stpotomotif/PROYEK_BMS_NUVOTON/PROYEK_BMS_NUVOTON.kicad_pcb

## KiCad design PROYEK_BMS_NUVOTON.kicad_pcb (2024-03-11)

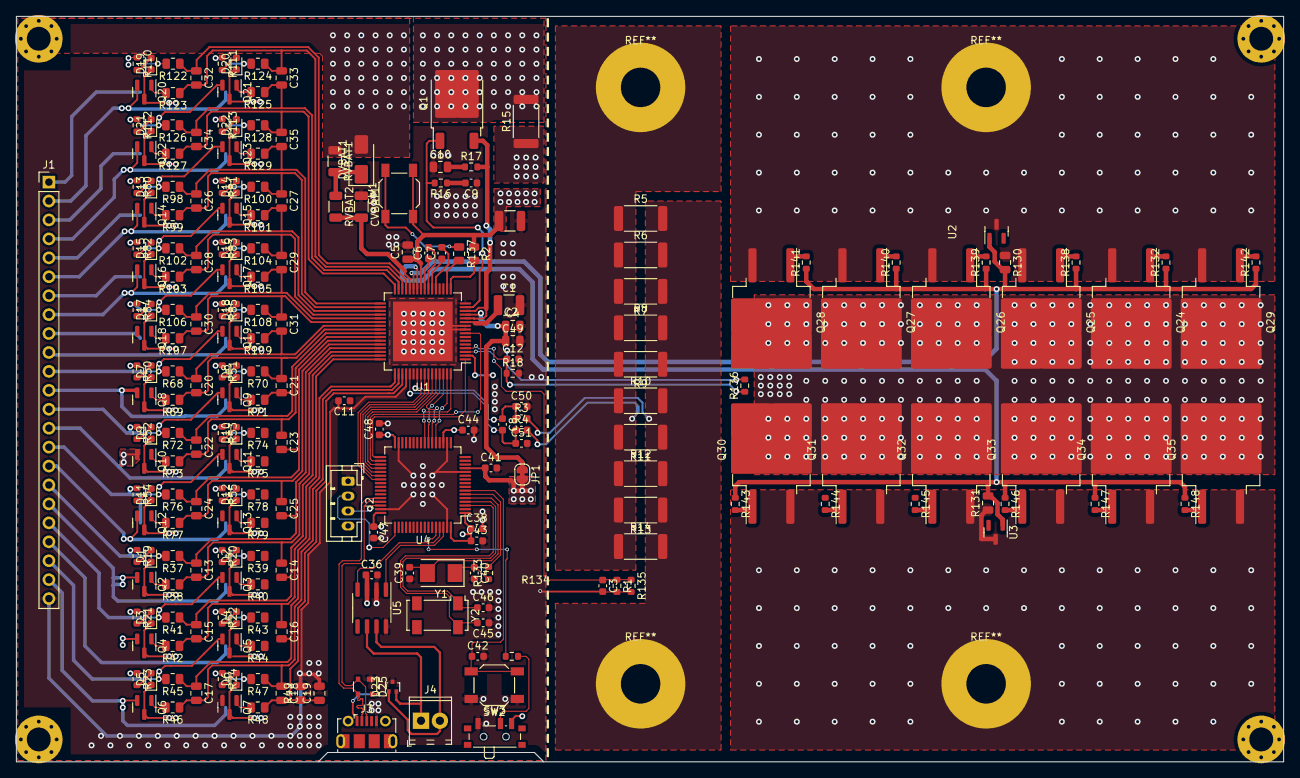
[picture p1: board PROYEK_BMS_NUVOTON.kicad_pcb from above]

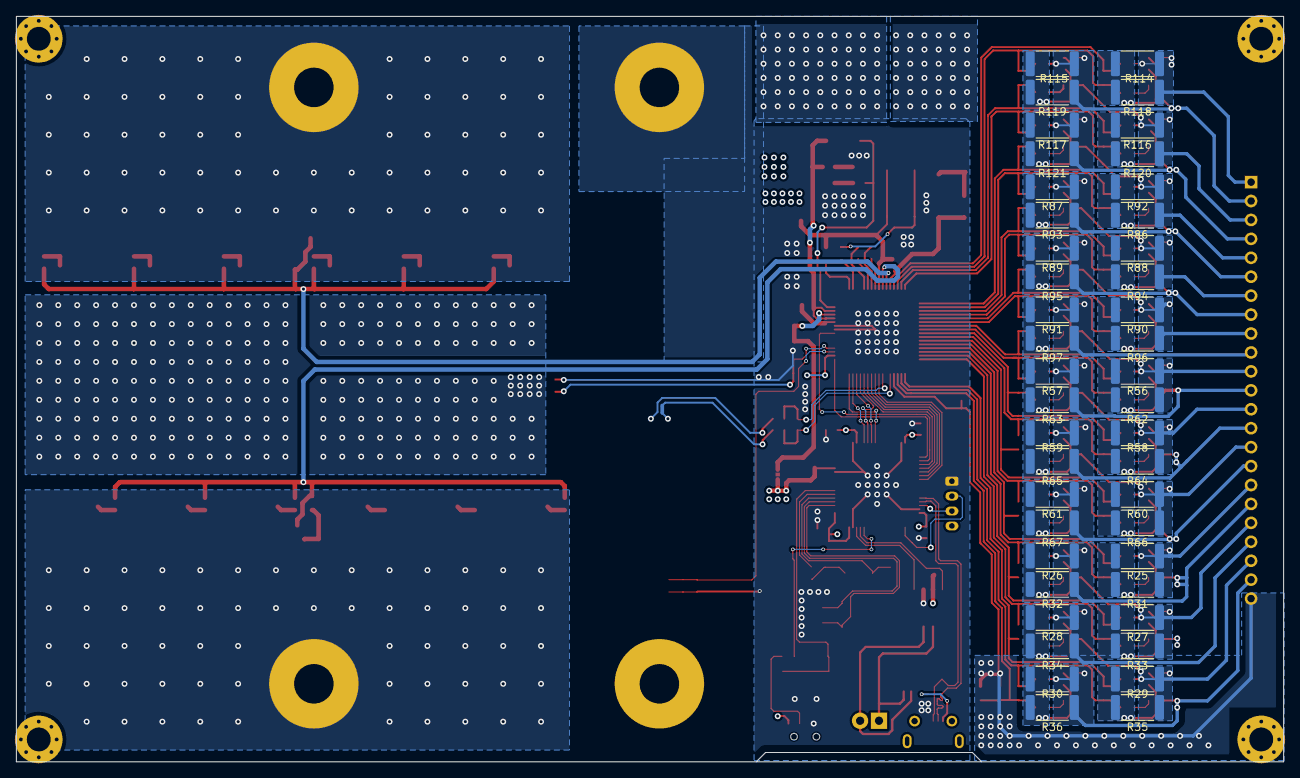
[picture p2: board PROYEK_BMS_NUVOTON.kicad_pcb from below]

Board: 4 copper layers, 170.0 x 100.0 mm, 277 parts (45 on the bottom side), 179 nets.

Parts:
C1: 4.7u; C_1210_3225Metric
C2: 1u; C_1210_3225Metric
C3, C12: 1n; C_0603_1608Metric
C4: 1u; C_0805_2012Metric
C5: 0.1u; C_0805_2012Metric
C6, C7: 0.68u; C_0603_1608Metric
C8, C50, C51: 0.1u; C_0603_1608Metric
C9: 22n; C_0603_1608Metric
C10: 10u; C_0805_2012Metric
C11: 100n; C_0603_1608Metric
C13, C14, C15, C16, C17, C18, C19, C20, C21, C22, C23, C24, C25, C26, C27, C28, C29, C30, C31, C32, C33, C34, C35: 180n; C_0805_2012Metric
C36, C38, C41, C42, C43, C44, C47: 100n,0603; C_0603_1608Metric
C39, C40, C45, C46: 20p,0603; C_0603_1608Metric
C48: 4.7u,0603; C_0603_1608Metric
C49: 0.1 uF; C_0805_2012Metric
CVBAT1: 1uF; C_1206_3216Metric
D1, D2, D3, D4, D5, D6, D7, D8, D9, D10, D11, D12, D13, D14, D15, D16, D17, D18, D19, D20, D21, D22: LED; LED_0603_1608Metric
D23: RCLAMP0502B; SOT-416
D25: PRTR5V0U2X; SOT-143
DVBAT1: US1M; D_SMA
J1: Conn_01x23_Pin; PinHeader_1x23_P2.54mm_Vertical
J2: Conn_01x04_Pin; JST_PH_B4B-PH-K_1x04_P2.00mm_Vertical
J3: USB_B_Micro; USB_Micro-B_Molex-105017-0001
J4: Screw_Terminal_01x02; TerminalBlock_Phoenix_MPT-0,5-2-2.54_1x02_P2.54mm_Horizontal
JP1: Jumper_2_Bridged; SolderJumper-2_P1.3mm_Bridged_RoundedPad1.0x1.5mm
NT1: NetTie_2; NetTie-2_SMD_Pad0.5mm
Q1: NPN; TO-252-2
Q2, Q3, Q4, Q5, Q6, Q7, Q8, Q9, Q10, Q11, Q12, Q13, Q14, Q15, Q16, Q17, Q18, Q19, Q20, Q21, Q22, Q23: Q_NMOS_GSD; SOT-23
Q24, Q25, Q26, Q27, Q28, Q29, Q30, Q31, Q32, Q33, Q34, Q35: NMOS; TO-263-2
R1, R18: 47k; R_0603_1608Metric
R2: 30k; R_0805_2012Metric
R3, R4: 100; C_0603_1608Metric
R5, R6, R7, R8, R9, R10, R11, R12, R13, R14: 10m; R_2512_6332Metric
R15: 100; R_2512_6332Metric
R16: 18k; R_0603_1608Metric
R17: 0.1; R_0603_1608Metric
R19, R20, R21, R22, R23, R24, R50, R51, R52, R53, R54, R55, R80, R81, R82, R83, R84, R85, R110, R111, R112, R113: 4k7; R_0603_1608Metric
R25, R26, R27, R28, R29, R30, R31, R32, R33, R34, R35, R36, R56, R57, R58, R59, R60, R61, R62, R63, R64, R65, R66, R67, R86, R87, R88, R89, R90, R91, R92, R93, R94, R95, R96, R97, R114, R115, R116, R117, R118, R119, R120, R121: 36; R_2512_6332Metric
R37, R39, R41, R43, R45, R47, R49, R68, R70, R72, R74, R76, R78, R98, R100, R102, R104, R106, R108, R122, R124, R126, R128: 910; R_0805_2012Metric
R38, R40, R42, R44, R46, R48, R69, R71, R73, R75, R77, R79, R99, R101, R103, R105, R107, R109, R123, R125, R127, R129: 1k; R_0805_2012Metric
R130, R131: 10M; C_0805_2012Metric
R132, R138, R139, R140, R141, R142, R143, R144, R145, R146, R147, R148: 2R2; R_0603_1608Metric
R133: 390,0603; R_0603_1608Metric
R134: 10k,0603; R_0603_1608Metric
R135, R136: NTC10k; R_0603_1608Metric
R137: 75M; R_0805_2012Metric
RVBAT1, RVBAT2: 100; R_1206_3216Metric
SW1, SW2: SW_Push; SW_SPST_SKQG_WithStem
SW3: SW_SPDT; SW_SPDT_PCM12
U1: KA49522; HTQFP-64-1EP_10x10mm_P0.5mm_EP8x8mm
U2, U3: TL431DBZ; SOT-23
U4: STM32F072RBTx; LQFP-64_10x10mm_P0.5mm
U5: SN65HVD230; SOIC-8_3.9x4.9mm_P1.27mm
Y1: 8M,SMD; Crystal_SMD_5032-2Pin_5.0x3.2mm
Y2: 32.768k,SMD; Crystal_SMD_Abracon_ABS25-4Pin_8.0x3.8mm

Connections:
+3V3: C36.1, C38.1, C41.1, C43.1, C44.1, C47.1, C48.1, J2.4, JP1.2 (B), SW3.3 (C), U4.1 (VBAT), U4.13 (VDDA), U4.19 (VDD), U4.32 (VDD), U4.48 (VDDIO2), U4.64 (VDD), U5.3 (VCC)
/BOOT0: R134.2, U4.60 (BOOT0)
/CAN_D+: D23.1 (K1), J4.2, U5.7 (CANH)
/CAN_D-: D23.2 (K2), J4.1, U5.6 (CANL)
/CAN_RX: U4.61 (PB8), U5.4 (R)
/CAN_TX: U4.62 (PB9), U5.1 (D)
/OSC32_IN: C45.2, U4.3 (PC14), Y2.4
/OSC32_OUT: C46.1, U4.4 (PC15), Y2.1
/OSC_IN: C39.2, U4.5 (PF0), Y1.2
/OSC_OUT: R133.2, U4.6 (PF1)
/RESET: C42.1, SW2.2, U4.7 (NRST)
/SWCLK: J2.2, U4.49 (PA14)
/SWDIO: J2.3, U4.46 (PA13)
/USB_D+: D25.2 (I/O1), J3.3 (D+), U4.45 (PA12)
/USB_D-: D25.3 (I/O2), J3.2 (D-), U4.44 (PA11)
ALARM1: U1.59 (ALARM1), U4.36 (PB15)
BMS_3.3V: C4.1, C49.1, JP1.1 (A), U1.2 (CVDD), U1.13 (REGEXT)
C0: C11.1, C18.2, C19.1, R48.1, R49.1, U1.51 (C0)
C1: C17.2, C18.1, R46.1, R47.1, U1.50 (C1)
C2: C16.2, C17.1, R44.1, R45.1, U1.49 (C2)
C3: C15.2, C16.1, R42.1, R43.1, U1.48 (C3)
C4: C14.2, C15.1, R40.1, R41.1, U1.47 (C4)
C5: C13.2, C14.1, R38.1, R39.1, U1.46 (C5)
C6: C13.1, C25.2, R37.1, R79.1, U1.45 (C6)
C7: C24.2, C25.1, R77.1, R78.1, U1.44 (C7)
C8: C23.2, C24.1, R75.1, R76.1, U1.43 (C8)
C9: C22.2, C23.1, R73.1, R74.1, U1.42 (C9)
C10: C21.2, C22.1, R71.1, R72.1, U1.41 (C10)
C11: C20.2, C21.1, R69.1, R70.1, U1.40 (C11)
C12: C20.1, C31.2, R68.1, R109.1, U1.39 (C12)
C13: C30.2, C31.1, R107.1, R108.1, U1.38 (C13)
C14: C29.2, C30.1, R105.1, R106.1, U1.37 (C14)
C15: C28.2, C29.1, R103.1, R104.1, U1.36 (C15)
C16: C27.2, C28.1, R101.1, R102.1, U1.35 (C16)
C17: C26.2, C27.1, R99.1, R100.1, U1.34 (C17)
C18: C26.1, C35.2, R98.1, R129.1, U1.33 (C18)
C19: C34.2, C35.1, R127.1, R128.1, U1.32 (C19)
C20: C33.2, C34.1, R125.1, R126.1, U1.31 (C20)
C21: C32.2, C33.1, R123.1, R124.1, U1.30 (C21)
C22: C32.1, R122.1, U1.29 (C22)
CHG: R130.2, R132.1, R138.1, R139.1, R140.1, R141.1, R142.1, U1.27 (CHG), U2.1 (K)
CLK: U1.63 (SCL), U4.21 (PA5)
CN4_C1: J1.22, Q6.2 (S), R24.1, R30.1, R36.1, R47.2
CN4_C2: J1.21, Q5.2 (S), R23.1, R29.1, R35.1, R45.2
CN4_C3: J1.20, Q4.2 (S), R22.1, R28.1, R34.1, R43.2
CN4_C4: J1.19, Q3.2 (S), R21.1, R27.1, R33.1, R41.2
CN4_C5: J1.18, Q2.2 (S), R20.1, R26.1, R32.1, R39.2
CN4_C6: J1.17, Q13.2 (S), R19.1, R25.1, R31.1, R37.2
CN4_C7: J1.16, Q12.2 (S), R55.1, R61.1, R67.1, R78.2
CN4_C8: J1.15, Q11.2 (S), R54.1, R60.1, R66.1, R76.2
CN4_C9: J1.14, Q10.2 (S), R53.1, R59.1, R65.1, R74.2
CN4_C10: J1.13, Q9.2 (S), R52.1, R58.1, R64.1, R72.2
CN4_C11: J1.12, Q8.2 (S), R51.1, R57.1, R63.1, R70.2
CN4_C12: J1.11, Q19.2 (S), R50.1, R56.1, R62.1, R68.2
CN4_C13: J1.10, Q18.2 (S), R85.1, R91.1, R97.1, R108.2
CN4_C14: J1.9, Q17.2 (S), R84.1, R90.1, R96.1, R106.2
CN4_C15: J1.8, Q16.2 (S), R83.1, R89.1, R95.1, R104.2
CN4_C16: J1.7, Q15.2 (S), R82.1, R88.1, R94.1, R102.2
CN4_C17: J1.6, Q14.2 (S), R81.1, R87.1, R93.1, R100.2
CN4_C18: J1.5, Q23.2 (S), R80.1, R86.1, R92.1, R98.2
CN4_C19: J1.4, Q22.2 (S), R113.1, R117.1, R121.1, R128.2
CN4_C20: J1.3, Q21.2 (S), R112.1, R116.1, R120.1, R126.2
CN4_C21: J1.2, Q20.2 (S), R111.1, R115.1, R119.1, R124.2
CN4_C22: DVBAT1.2 (A), J1.1, Q24.3 (S), Q25.3 (S), Q26.3 (S), Q27.3 (S), Q28.3 (S), Q29.3 (S), R110.1, R114.1, R118.1, R122.2, R130.1, RVBAT1.1, U2.3 (A)
DIS: R131.2, R143.1, R144.1, R145.1, R146.1, R147.1, R148.1, U1.26 (DIS), U3.1 (K)
EN: U1.64 (SEN), U4.24 (PC4)
FETOFF: U1.60 (FETOFF), U4.35 (PB14)
GND: C1.2, C2.2, C3.2, C4.2, C5.2, C9.1, C10.1, C11.2, C12.2, C19.2, C36.2, C38.2, C39.1, C40.2, C41.2, C42.2, C43.2, C44.2, C45.1, C46.2, C47.2, C48.2, C49.2, C50.2, C51.2, CVBAT1.1, D23.3 (A), D25.1 (GND), J1.23, J2.1, J3.5 (GND), NT1.1, Q7.2 (S), R1.2, R5.1, R6.1, R7.2, R8.1, R9.2, R10.1, R11.2, R12.1, R13.2, R14.1, R18.2, R49.2, R135.2, R136.2, SW2.1, SW3.1 (A), U1.9 (MODE), U1.10 (AVSS1), U1.16 (AVSS2), U1.52 (GND), U1.65 (GND), U4.12 (VSSA), U4.18 (VSS), U4.31 (VSS), U4.47 (VSS), U4.63 (VSS), U5.2 (GND), U5.8 (Rs)
GPIO1: U1.56 (GPIO1), U4.39 (PC8)
GPIO2: U1.57 (GPIO2), U4.38 (PC7)
GPIO3: U1.58 (GPIO3), U4.37 (PC6)
NRST: U1.1 (NRST), U4.33 (PB12)
unnamed: C9.2, R16.1
unnamed: C10.2, R17.1
unnamed: C40.1, R133.1, Y1.1
unnamed: D1.2 (A), R19.2
unnamed: D1.1 (K), Q2.3 (D), R25.2, R31.2
unnamed: D2.2 (A), R20.2
unnamed: D2.1 (K), Q3.3 (D), R26.2, R32.2
unnamed: D3.2 (A), R21.2
unnamed: D3.1 (K), Q4.3 (D), R27.2, R33.2
unnamed: D4.2 (A), R22.2
unnamed: D4.1 (K), Q5.3 (D), R28.2, R34.2
unnamed: D5.2 (A), R23.2
unnamed: D5.1 (K), Q6.3 (D), R29.2, R35.2
unnamed: D6.2 (A), R24.2
unnamed: D6.1 (K), Q7.3 (D), R30.2, R36.2
unnamed: D7.2 (A), R50.2
unnamed: D7.1 (K), Q8.3 (D), R56.2, R62.2
unnamed: D8.2 (A), R51.2
unnamed: D8.1 (K), Q9.3 (D), R57.2, R63.2
unnamed: D9.2 (A), R52.2
unnamed: D9.1 (K), Q10.3 (D), R58.2, R64.2
unnamed: D10.2 (A), R53.2
unnamed: D10.1 (K), Q11.3 (D), R59.2, R65.2
unnamed: D11.2 (A), R54.2
unnamed: D11.1 (K), Q12.3 (D), R60.2, R66.2
unnamed: D12.2 (A), R55.2
unnamed: D12.1 (K), Q13.3 (D), R61.2, R67.2
unnamed: D13.2 (A), R80.2
unnamed: D13.1 (K), Q14.3 (D), R86.2, R92.2
unnamed: D14.2 (A), R81.2
unnamed: D14.1 (K), Q15.3 (D), R87.2, R93.2
unnamed: D15.2 (A), R82.2
unnamed: D15.1 (K), Q16.3 (D), R88.2, R94.2
unnamed: D16.2 (A), R83.2
unnamed: D16.1 (K), Q17.3 (D), R89.2, R95.2
unnamed: D17.2 (A), R84.2
unnamed: D17.1 (K), Q18.3 (D), R90.2, R96.2
unnamed: D18.2 (A), R85.2
unnamed: D18.1 (K), Q19.3 (D), R91.2, R97.2
unnamed: D19.2 (A), R110.2
unnamed: D19.1 (K), Q20.3 (D), R114.2, R118.2
unnamed: D20.2 (A), R111.2
unnamed: D20.1 (K), Q21.3 (D), R115.2, R119.2
unnamed: D21.2 (A), R112.2
unnamed: D21.1 (K), Q22.3 (D), R116.2, R120.2
unnamed: D22.2 (A), R113.2
unnamed: D22.1 (K), Q23.3 (D), R117.2, R121.2
unnamed: DVBAT1.1 (K), RVBAT1.2, RVBAT2.1
unnamed: NT1.2, R4.2
unnamed: Q1.2 (C), R15.2
unnamed: Q2.1 (G), R38.2
unnamed: Q3.1 (G), R40.2
unnamed: Q4.1 (G), R42.2
unnamed: Q5.1 (G), R44.2
unnamed: Q6.1 (G), R46.2
unnamed: Q7.1 (G), R48.2
unnamed: Q8.1 (G), R69.2
unnamed: Q9.1 (G), R71.2
unnamed: Q10.1 (G), R73.2
unnamed: Q11.1 (G), R75.2
unnamed: Q12.1 (G), R77.2
unnamed: Q13.1 (G), R79.2
unnamed: Q14.1 (G), R99.2
unnamed: Q15.1 (G), R101.2
unnamed: Q16.1 (G), R103.2
unnamed: Q17.1 (G), R105.2
unnamed: Q18.1 (G), R107.2
unnamed: Q19.1 (G), R109.2
unnamed: Q20.1 (G), R123.2
unnamed: Q21.1 (G), R125.2
unnamed: Q22.1 (G), R127.2
unnamed: Q23.1 (G), R129.2
unnamed: Q24.1 (G), R132.2
unnamed: Q25.1 (G), R138.2
unnamed: Q26.1 (G), R139.2
unnamed: Q27.1 (G), R140.2
unnamed: Q28.1 (G), R141.2
unnamed: Q29.1 (G), R142.2
unnamed: Q30.1 (G), R143.2
unnamed: Q31.1 (G), R144.2
unnamed: Q32.1 (G), R145.2
unnamed: Q33.1 (G), R146.2
unnamed: Q34.1 (G), R147.2
unnamed: Q35.1 (G), R148.2
unnamed: R137.1, SW1.1
unnamed: R134.1, SW3.2 (B)
unnamed: C7.1, U1.22 (CN1)
unnamed: C6.2, U1.23 (CN2)
unnamed: C7.2, U1.21 (CP1)
unnamed: C6.1, U1.24 (CP2)
unnamed: R2.2, U1.17 (LDM)
unnamed: R137.2, U1.18 (VPC)
REGB: Q1.1 (B), R16.2, U1.15 (REGB)
REG_SUP: Q24.2 (D), Q25.2 (D), Q26.2 (D), Q27.2 (D), Q28.2 (D), Q29.2 (D), Q30.2 (D), Q31.2 (D), Q32.2 (D), Q33.2 (D), Q34.2 (D), Q35.2 (D), R15.1
SDI: U1.62 (SDI), U4.23 (PA7)
SDO: U1.61 (SDO), U4.22 (PA6), U4.25 (PC5)
SHDN: U1.8 (SHDN), U4.34 (PB13)
SRN: C8.1, C50.1, R3.1, U1.55 (SRN)
SRP: C8.2, C51.1, R4.1, U1.53 (SRP)
TMON1: C3.1, R1.1, R135.1, U1.3 (TMONI1)
TMON2: C12.1, R18.1, R136.1, U1.4 (TMONI2)
USB_5V: D25.4 (VCC), J3.1 (VBUS)
VBAT-P: CVBAT1.2, RVBAT2.2, U1.28 (VBAT)
VDD18: C1.1, U1.11 (VDD18)
VDD55: Q1.3 (E), R17.2, U1.12 (REGSEL), U1.14 (VDD55)
VPACK+: C2.1, C5.1, Q30.3 (S), Q31.3 (S), Q32.3 (S), Q33.3 (S), Q34.3 (S), Q35.3 (S), R2.1, R131.1, SW1.2, U1.25 (VPACK), U3.3 (A)
VPACK-: R3.2, R5.2, R6.2, R7.1, R8.2, R9.1, R10.2, R11.1, R12.2, R13.1, R14.2
