stpotomotif/PROYEK_BMS_NUVOTON/(commit log)

2024-03-03 first init
    [PROYEK_BMS_NUVOTON.csv, PROYEK_BMS_NUVOTON.kicad_pcb, PROYEK_BMS_NUVOTON.kicad_sch, bom.csv, designators.csv, positions.csv]
2024-03-04 revision 2, 12 error fix on bms connection with STM32, USB circuit need some adjustment
    [PROYEK_BMS_NUVOTON.kicad_sch]
2024-03-11 revision 7 March
    [PROYEK_BMS_NUVOTON.kicad_pcb, PROYEK_BMS_NUVOTON.kicad_sch]
2024-04-15 revision 11 march
    [PROYEK_BMS_NUVOTON.kicad_sch]
